Danjovic/clOCkTAL/README.md

# clOCkTAL
Binary Coded Octal clock with auto brightness control, based on a PIC16F688
