Danjovic/clOCkTAL/doc/bottom.png

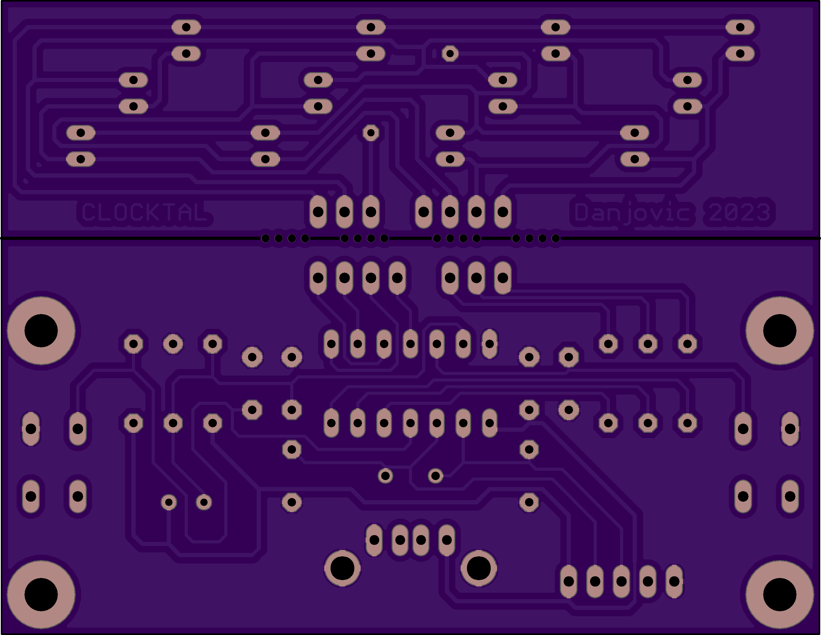
doc/bottom.png
