Danjovic/clOCkTAL/doc/top.png

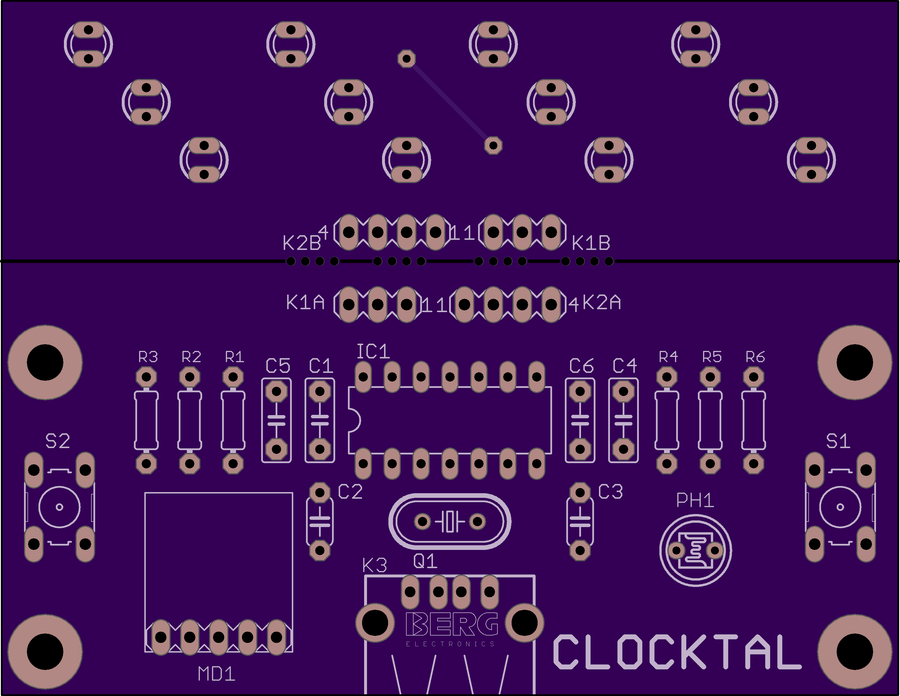
doc/top.png
