Danjovic/clOCkTAL/doc/clocktal.pdf

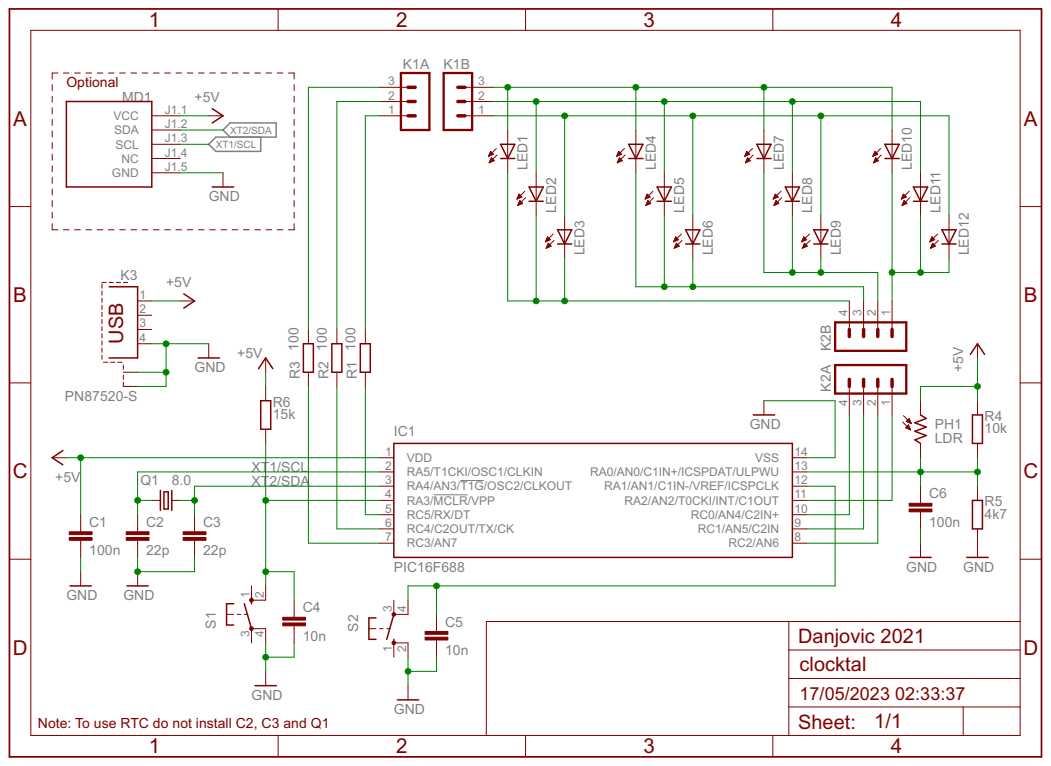
[picture p3: page 1]

Q1 8.0 XT2/SDA | 3 | 12

4 | 11

Note: To use RTC do not install C2, C3 and Q1
