Danjovic/clOCkTAL/circuit/clocktal.brd

## EAGLE design circuit/clocktal.brd (2023-05-17)

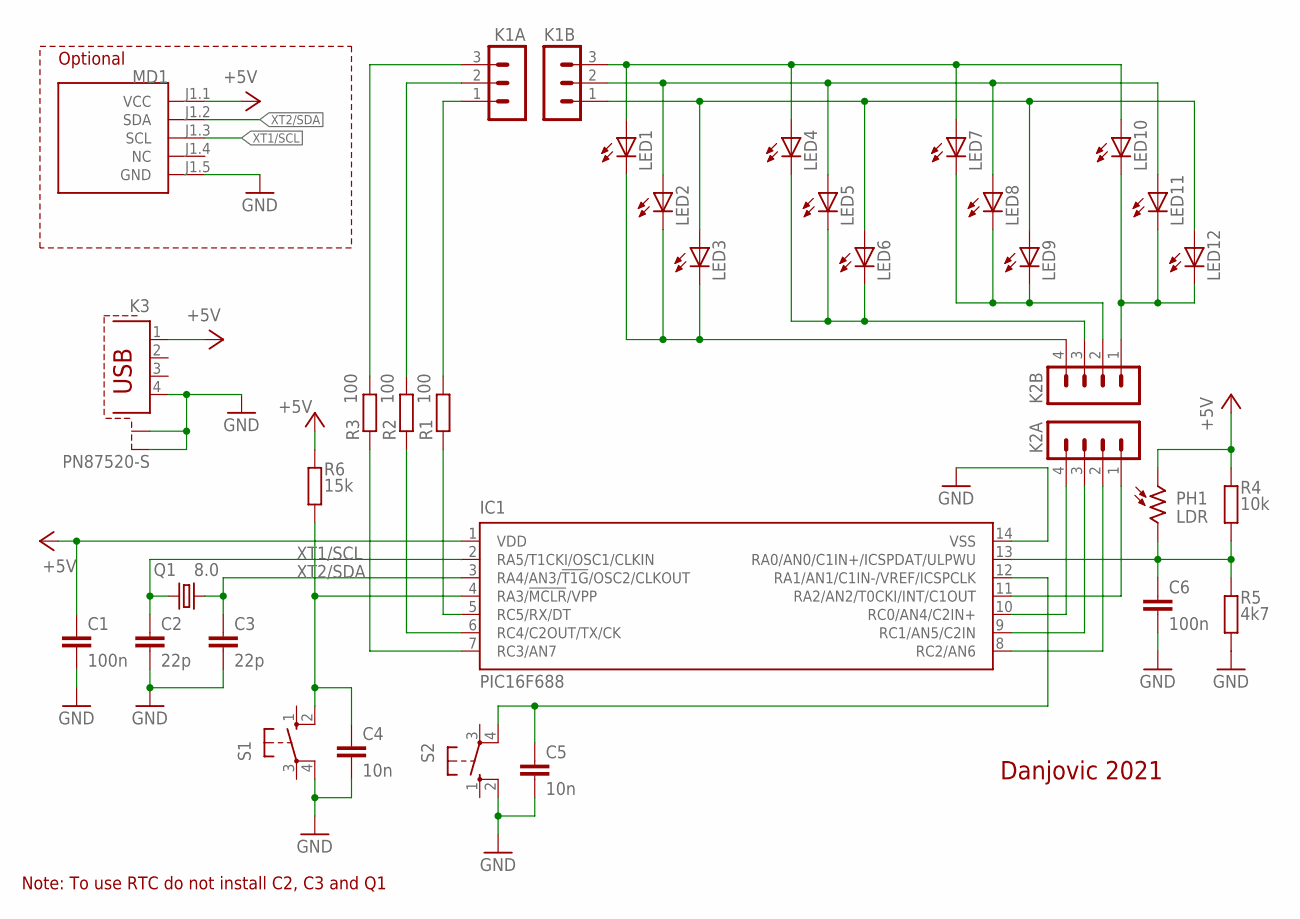
[picture p4: schematic clocktal.sch]

Parts:
C1, C6: 100n; C050-025X75L
C2, C3: 22p; C050-024X044L
C4, C5: 10n; C050-025X75L
IC1: PIC16F688; DIL14
K1A, K1B: MA03-1
K2A, K2B: MA04-1
K3: PN87520-S
LED1, LED2, LED3, LED4, LED5, LED6, LED7, LED8, LED9, LED10, LED11, LED12: LED3MM_L
MD1: RTC-DS3231_L; RTC-DS3231-SMALL_L
PH1: LDR; T0-46-A10XX
Q1: 8.0; HC49U-V
R1, R2, R3: 100; 0204/7L
R4: 10k; 0204/7L
R5: 4k7; 0204/7L
R6: 15k; 0204/7L
S1, S2: 10-XX; B3F-10XX

Connections:
+5V: C1.1, IC1.1 (VDD), K3.1, MD1.J1.1 (VCC), PH1.1, R4.1, R6.1
B0: K1B.1, LED3.A, LED6.A, LED9.A, LED12.A
B1: K1B.2, LED2.A, LED5.A, LED8.A, LED11.A
B2: K1B.3, LED1.A, LED4.A, LED7.A, LED10.A
BIT0: IC1.5 (RC5/RX/DT), R1.1
BIT0A: K1A.1, R1.2
BIT1: IC1.6 (RC4/C2OUT/TX/CK), R2.1
BIT1A: K1A.2, R2.2
BIT2: IC1.7 (RC3/AN7), R3.1
BIT2A: K1A.3, R3.2
BUTTON1: C4.1, IC1.4 (RA3/!MCLR!/VPP), R6.2, S1.2 (S1)
BUTTON2: C5.1, IC1.12 (RA1/AN1/C1IN-/VREF/ICSPCLK), S2.4 (P1)
DGT0: K2B.1, LED10.K (C), LED11.K (C), LED12.K (C)
DGT1: K2B.2, LED7.K (C), LED8.K (C), LED9.K (C)
DGT2: K2B.3, LED4.K (C), LED5.K (C), LED6.K (C)
DGT3: K2B.4, LED1.K (C), LED2.K (C), LED3.K (C)
DIGIT0: IC1.11 (RA2/AN2/T0CKI/INT/C1OUT), K2A.1
DIGIT1: IC1.8 (RC2/AN6), K2A.2
DIGIT2: IC1.9 (RC1/AN5/C2IN), K2A.3
DIGIT3: IC1.10 (RC0/AN4/C2IN+), K2A.4
GND: C1.2, C2.2, C3.2, C4.2, C5.2, C6.2, IC1.14 (VSS), K3.4, K3.S1, K3.S2, MD1.J1.5 (GND), R5.1, S1.4 (P1), S2.2 (S1)
LDR: C6.1, IC1.13 (RA0/AN0/C1IN+/ICSPDAT/ULPWU), PH1.2, R4.2, R5.2
XT1/SCL: C2.1, IC1.2 (RA5/T1CKI/OSC1/CLKIN), MD1.J1.3 (SCL), Q1.1
XT2/SDA: C3.1, IC1.3 (RA4/AN3/!T1G!/OSC2/CLKOUT), MD1.J1.2 (SDA), Q1.2

Notes on the sheet:
Danjovic 2021
Optional
Note: To use RTC do not install C2, C3 and Q1

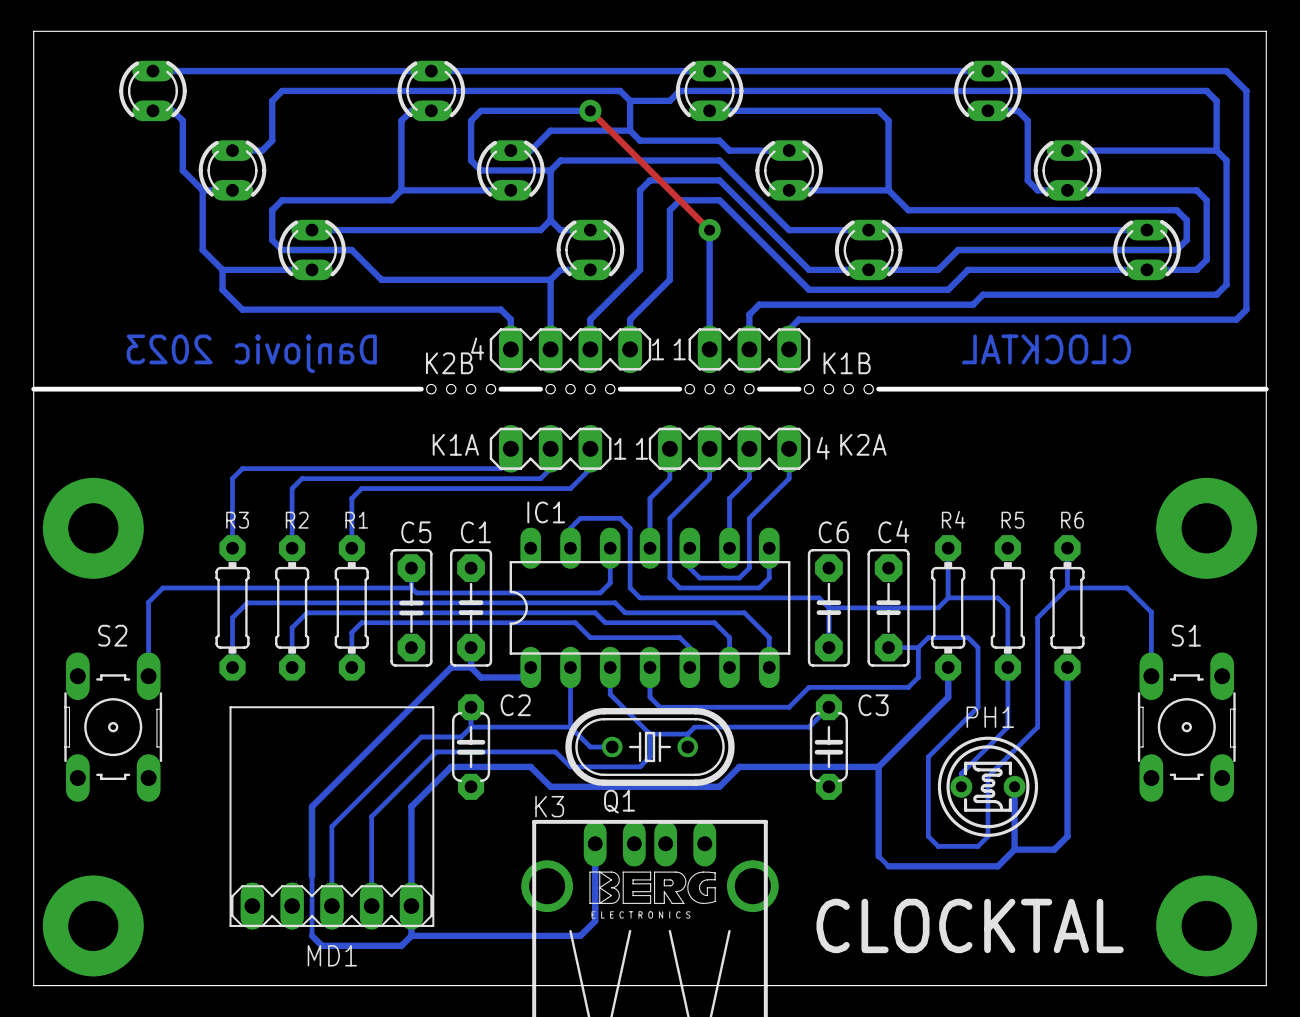
[picture p5: board clocktal.brd from above]

Board: 2 copper layers, 78.7 x 61.0 mm, 35 parts (0 on the bottom side), 24 nets.
