Danjovic/clOCkTAL/(commit log)

2021-08-29 Basic Release
    [clocktal.brd, clocktal.sch]
2023-05-17 added Single Sided PCB design
    [clocktal.brd, clocktal.sch]
2023-05-17 Improved PCB aesthetics
    [clocktal.brd]
2023-05-17 Added rendered images of PCB
